ifilot/picobeam/pcb/pico2-vga-adapter/pico2-vga-adapter.kicad_pcb

## KiCad design pcb/pico2-vga-adapter/pico2-vga-adapter.kicad_pcb (2025-03-22)

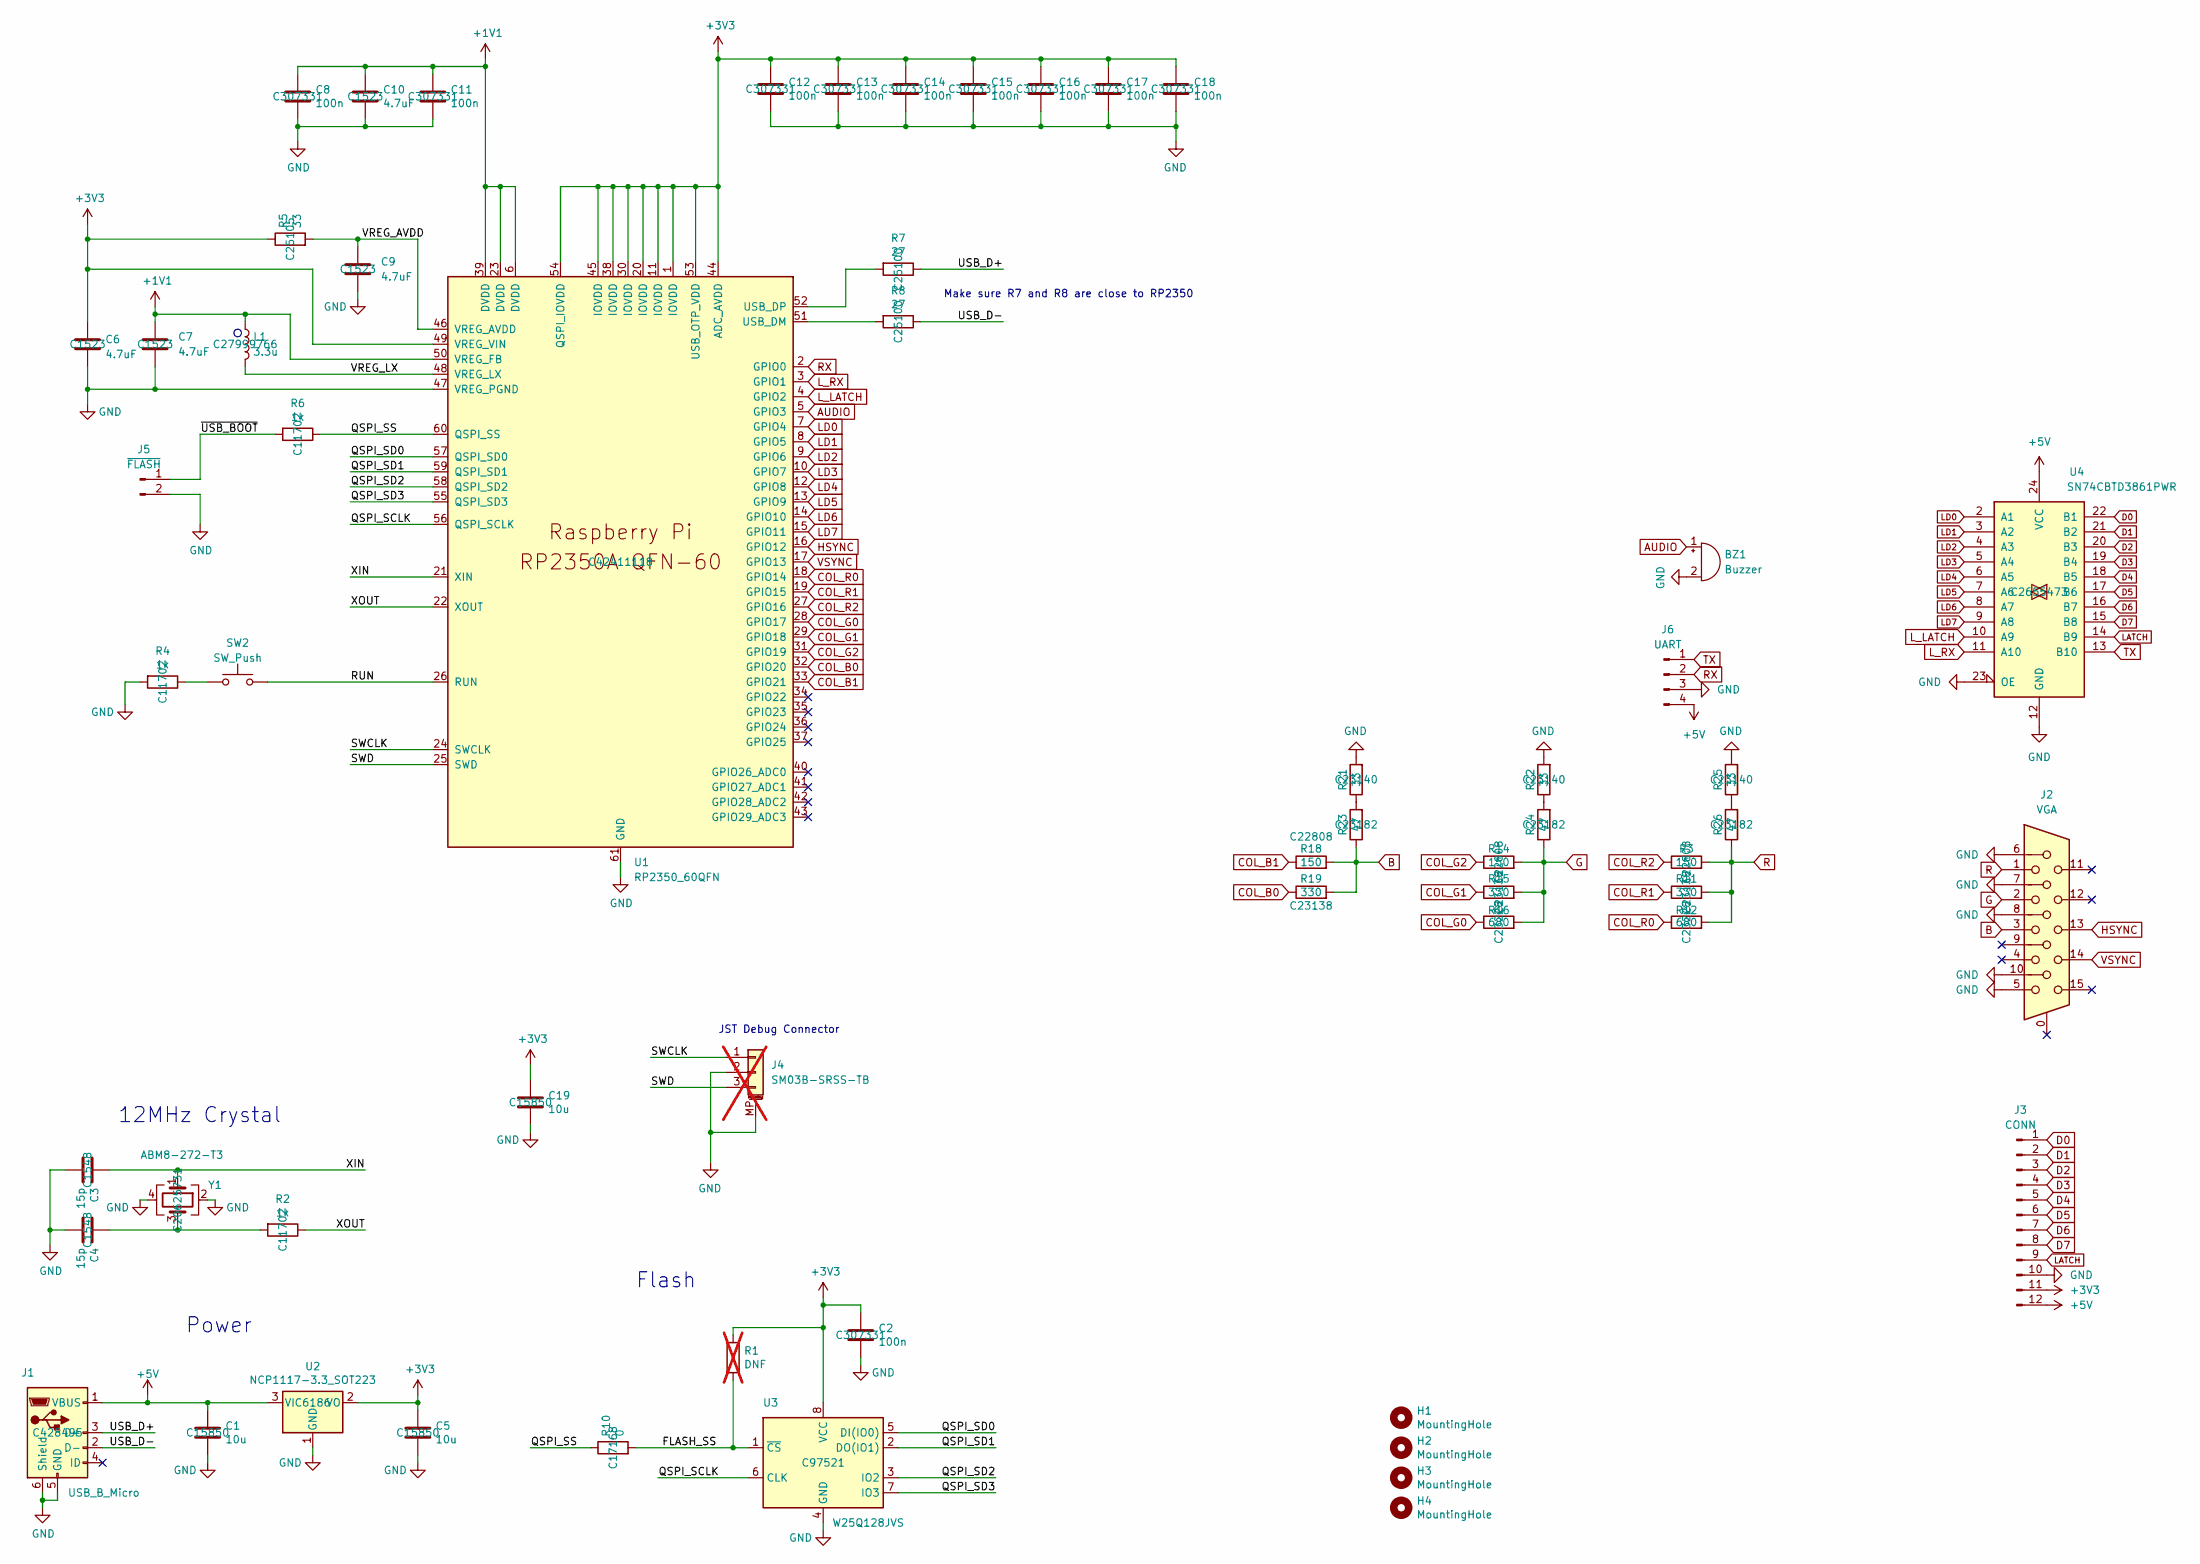
[picture p1: schematic pico2-vga-adapter.kicad_sch]

Parts:
BZ1: Buzzer; Buzzer_15x7.5RM7.6
C1, C5, C19: 10u; C_0805_2012Metric; LCSC C15850
C2, C8, C11, C12, C13, C14, C15, C16, C17, C18: 100n; C_0402_1005Metric; LCSC C307331
C3, C4: 15p; C_0402_1005Metric; LCSC C1548
C6, C7: 4.7uF; C_0402_1005Metric_small_pads; LCSC C1523
C9, C10: 4.7uF; C_0402_1005Metric; LCSC C1523
H1, H2, H3, H4: MountingHole; MountingHole_2.7mm_M2.5
J1: USB_B_Micro; USB_Micro-B_Amphenol_10103594-0001LF_Horizontal; LCSC C428495
J2: VGA; 618015330923
J3: CONN; PinHeader_1x12_P2.54mm_Vertical
J4: SM03B-SRSS-TB; JST_SH_SM03B-SRSS-TB_1x03-1MP_P1.00mm_Horizontal; not fitted
J5: ~{FLASH}; PinSocket_1x02_P2.54mm_Vertical
J6: UART; PinHeader_1x04_P2.54mm_Vertical
L1: 3.3u; L_pol_2016; LCSC C27999766
R1: DNF; R_0402_1005Metric; not fitted
R2, R4, R6: 1k; R_0402_1005Metric; LCSC C11702
R3, R14, R18: 150; C_0603_1608Metric; LCSC C22808
R5: 33; R_0402_1005Metric; LCSC C25105
R7, R8: 27; R_0402_1005Metric; LCSC C25100
R10: 0; R_0402_1005Metric; LCSC C17168
R11, R15, R19: 330; C_0603_1608Metric; LCSC C23138
R12, R16: 680; C_0603_1608Metric; LCSC C23228
R21, R22, R25: 33; C_0603_1608Metric; LCSC C23140
R23, R24, R26: 47; C_0603_1608Metric; LCSC C23182
SW2: SW_Push; SW_PUSH_6mm
U1: RP2350_60QFN; RP2350-QFN-60-1EP_7x7_P0.4mm_EP3.4x3.4mm_ThermalVias; LCSC C42411118
U2: NCP1117-3.3_SOT223; SOT-223-3_TabPin2; LCSC C6186
U3: W25Q128JVS; SOIC-8_5.23x5.23mm_P1.27mm; LCSC C97521
U4: SN74CBTD3861PWR; TSSOP-24_4.4x7.8mm_P0.65mm; LCSC C2655473
Y1: ABM8-272-T3; Crystal_SMD_3225-4Pin_3.2x2.5mm; LCSC C20625731

Connections:
+1V1: C7.1, C8.1, C10.1, C11.1, L1.1, U1.6 (DVDD), U1.23 (DVDD), U1.39 (DVDD), U1.50 (VREG_FB)
+3V3: C2.1, C5.1, C6.1, C12.1, C13.1, C14.1, C15.1, C16.1, C17.1, C18.1, C19.1, J3.11, R1.1, R5.1, U1.1 (IOVDD), U1.11 (IOVDD), U1.20 (IOVDD), U1.30 (IOVDD), U1.38 (IOVDD), U1.44 (ADC_AVDD), U1.45 (IOVDD), U1.49 (VREG_VIN), U1.53 (USB_OTP_VDD), U1.54 (QSPI_IOVDD), U2.2 (VO), U3.8 (VCC)
+5V: C1.1, J1.1 (VBUS), J3.12, J6.4, U2.3 (VI), U4.24 (VCC)
/FLASH_SS: R1.2, R10.2, U3.1 (~CS)
/QSPI_SCLK: U1.56 (QSPI_SCLK), U3.6 (CLK)
/QSPI_SD0: U1.57 (QSPI_SD0), U3.5 (DI(IO0))
/QSPI_SD1: U1.59 (QSPI_SD1), U3.2 (DO(IO1))
/QSPI_SD2: U1.58 (QSPI_SD2), U3.3 (IO2)
/QSPI_SD3: U1.55 (QSPI_SD3), U3.7 (IO3)
/QSPI_SS: R6.1, R10.1, U1.60 (QSPI_SS)
/RUN: SW2.2, U1.26 (RUN)
/SWCLK: J4.1, U1.24 (SWCLK)
/SWD: J4.3, U1.25 (SWD)
/USB_D+: J1.3 (D+), R7.1
/USB_D-: J1.2 (D-), R8.1
/VREG_AVDD: C9.1, R5.2, U1.46 (VREG_AVDD)
/VREG_LX: L1.2, U1.48 (VREG_LX)
/XIN: C3.1, U1.21 (XIN), Y1.1
/XOUT: R2.1, U1.22 (XOUT)
/~USB_BOOT: J5.1, R6.2
AUDIO: BZ1.1 (+), U1.5 (GPIO3)
B: J2.3, R18.2, R19.2, R23.1
COL_B0: R19.1, U1.32 (GPIO20)
COL_B1: R18.1, U1.33 (GPIO21)
COL_G0: R16.1, U1.28 (GPIO17)
COL_G1: R15.1, U1.29 (GPIO18)
COL_G2: R14.1, U1.31 (GPIO19)
COL_R0: R12.1, U1.18 (GPIO14)
COL_R1: R11.1, U1.19 (GPIO15)
COL_R2: R3.1, U1.27 (GPIO16)
D0: J3.1, U4.22 (B1)
D1: J3.2, U4.21 (B2)
D2: J3.3, U4.20 (B3)
D3: J3.4, U4.19 (B4)
D4: J3.5, U4.18 (B5)
D5: J3.6, U4.17 (B6)
D6: J3.7, U4.16 (B7)
D7: J3.8, U4.15 (B8)
G: J2.2, R14.2, R15.2, R16.2, R24.1
GND: BZ1.2 (-), C1.2, C2.2, C3.2, C4.2, C5.2, C6.2, C7.2, C8.2, C9.2, C10.2, C11.2, C12.2, C13.2, C14.2, C15.2, C16.2, C17.2, C18.2, C19.2, J1.5 (GND), J1.6 (Shield), J2.5, J2.6, J2.7, J2.8, J2.10, J3.10, J4.2, J4.MP (MountPin), J5.2, J6.3, R4.2, R21.2, R22.2, R25.2, U1.47 (VREG_PGND), U1.61 (GND), U2.1 (GND), U3.4 (GND), U4.12 (GND), U4.23 (OE), Y1.2, Y1.4
HSYNC: J2.13, U1.16 (GPIO12)
LATCH: J3.9, U4.14 (B9)
LD0: U1.7 (GPIO4), U4.2 (A1)
LD1: U1.8 (GPIO5), U4.3 (A2)
LD2: U1.9 (GPIO6), U4.4 (A3)
LD3: U1.10 (GPIO7), U4.5 (A4)
LD4: U1.12 (GPIO8), U4.6 (A5)
LD5: U1.13 (GPIO9), U4.7 (A6)
LD6: U1.14 (GPIO10), U4.8 (A7)
LD7: U1.15 (GPIO11), U4.9 (A8)
L_LATCH: U1.4 (GPIO2), U4.10 (A9)
L_RX: U1.3 (GPIO1), U4.11 (A10)
unnamed: C4.1, R2.2, Y1.3
unnamed: R4.1, SW2.1
unnamed: R21.1, R23.2
unnamed: R22.1, R24.2
unnamed: R25.1, R26.2
unnamed: R8.2, U1.51 (USB_DM)
unnamed: R7.2, U1.52 (USB_DP)
R: J2.1, R3.2, R11.2, R12.2, R26.1
RX: J6.2, U1.2 (GPIO0)
TX: J6.1, U4.13 (B10)
VSYNC: J2.14, U1.17 (GPIO13)

Notes on the sheet:
JST Debug Connector
Flash
Make sure R7 and R8 are close to RP2350
12MHz Crystal
Power

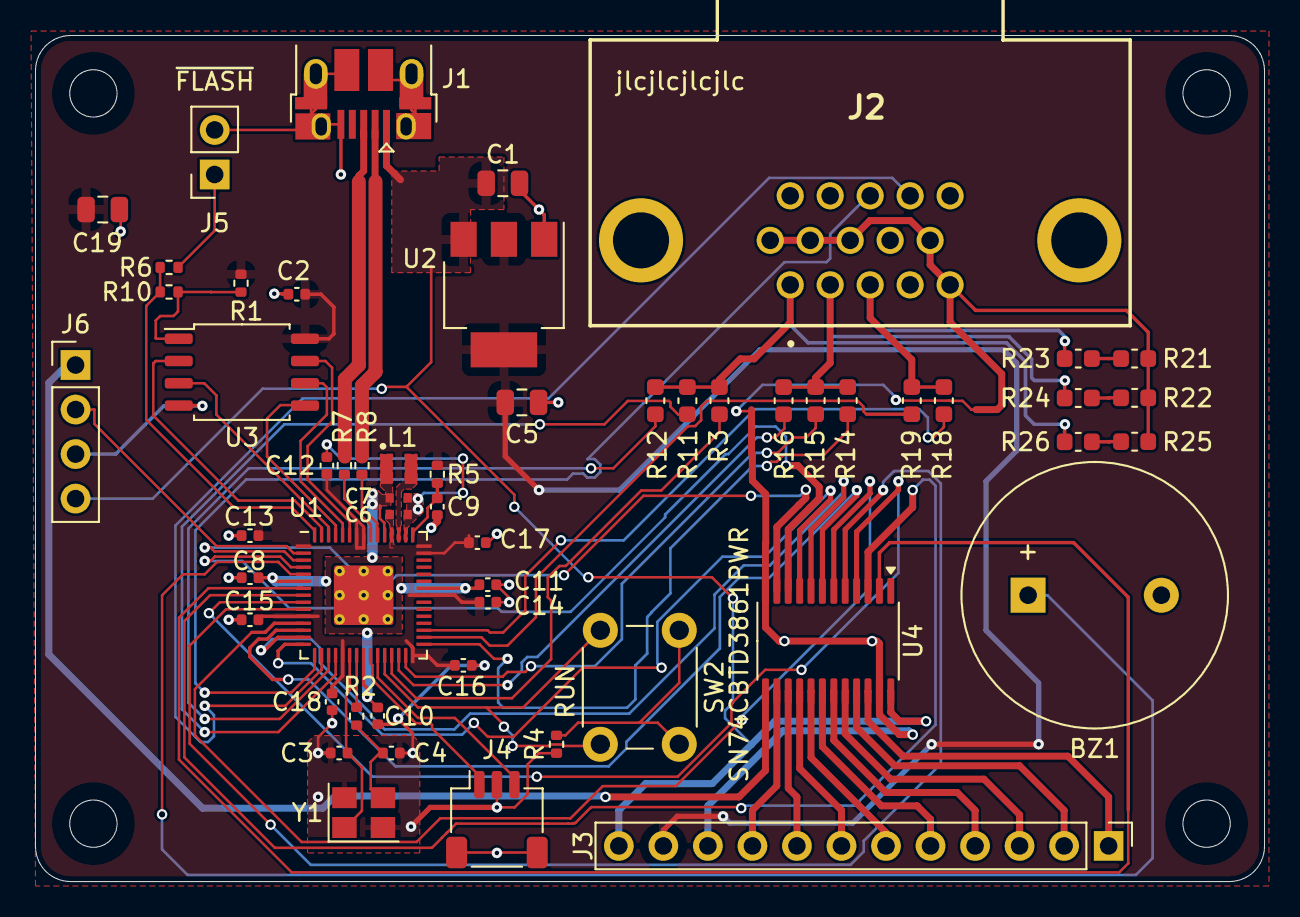
[picture p2: board pico2-vga-adapter.kicad_pcb from above]

Board: 2 copper layers, 70.1 x 48.3 mm, 59 parts (0 on the bottom side), 63 nets.
