ifilot/picobeam/(commit log)

2025-03-16 Designing PCB adapter
    [pico2-vga-adapter.kicad_pcb, pico2-vga-adapter.kicad_sch]
2025-03-20 Adding components
    [pico2-vga-adapter.kicad_pcb, pico2-vga-adapter.kicad_sch]
2025-03-22 Finalizing adapter design
    [pico2-vga-adapter.kicad_pcb, pico2-vga-adapter.kicad_sch]
